mjm-12/transistor-hfe-measurement-circuit/production/bom.csv

Designator | Footprint | Quantity | Value | LCSC Part #
C1, C7 | 0805 | 2 | 1u | C28323
C10, C11, C4, C8 | 0603 | 4 | 0.1u | C14663
C12, C13 | 0603 | 2 | 10u | C96446
C14, C15 | 0805 | 2 | 2200p | C28260
C16 | 0603 | 1 | 1000p | C1588
C3 | 1206 | 1 | 22u | C12891
C5 | 0603 | 1 | 0.01u | C57112
C6 | 0603 | 1 | 100p | C14858
D1, D2 | D_SOD-123 | 2 | MMSZ5245B | C19077428
D10, D11, D6, D7, D8, D9 | D_SOD-323 | 6 | 1N4148WS | C2128
D12, D13, D14, D4, D5 | 0603 | 5 | LED(RED) | C2286
D3 | D_SOD-123 | 1 | BZT52C15 | C19077412
Q1, Q3 | SOT-23 | 2 | HL2303 | C7420345
Q2 | SOT-23 | 1 | SS8550 Y2 | C8542
Q4 | SOT-563 | 1 | SSM6L56FE | C17604697
R1, R24 | 0603 | 2 | 100k | C25803
R10, R22, R34, R35, R36, R7 | 0603 | 6 | 3k3 | C22978
R11 | 0805 | 1 | 4R7 | C17675
R12 | 0603 | 1 | 1M | C22935
R13, R17, R19 | 0603 | 3 | 1k | C21190
R14, R23 | 0603 | 2 | 10M | C7250
R15, R16, R20, R21, R26, R27, R28, R29, R3, R30, R31, R32, R33 | 0603 | 13 | 10k | C25804
R18, R25 | 0603 | 2 | 0 | C21189
R2 | 0603 | 1 | 33k | C4216
R4 | 0603 | 1 | 470k | C23178
R5 | 0603 | 1 | 47k | C25819
R6 | 0603 | 1 | 6k8 | C23212
R8 | 0603 | 1 | 22k | C31850
R9 | 0603 | 1 | 18k | C25810
U2 | SOIC-14_3.9x8.7mm_P1.27mm | 1 | 74HC14D,653 | C5605
