mjm-12/transistor-hfe-measurement-circuit/transistor-hfe-measurement-circuit.kicad_pcb

## KiCad design transistor-hfe-measurement-circuit.kicad_pcb (2026-10-15)

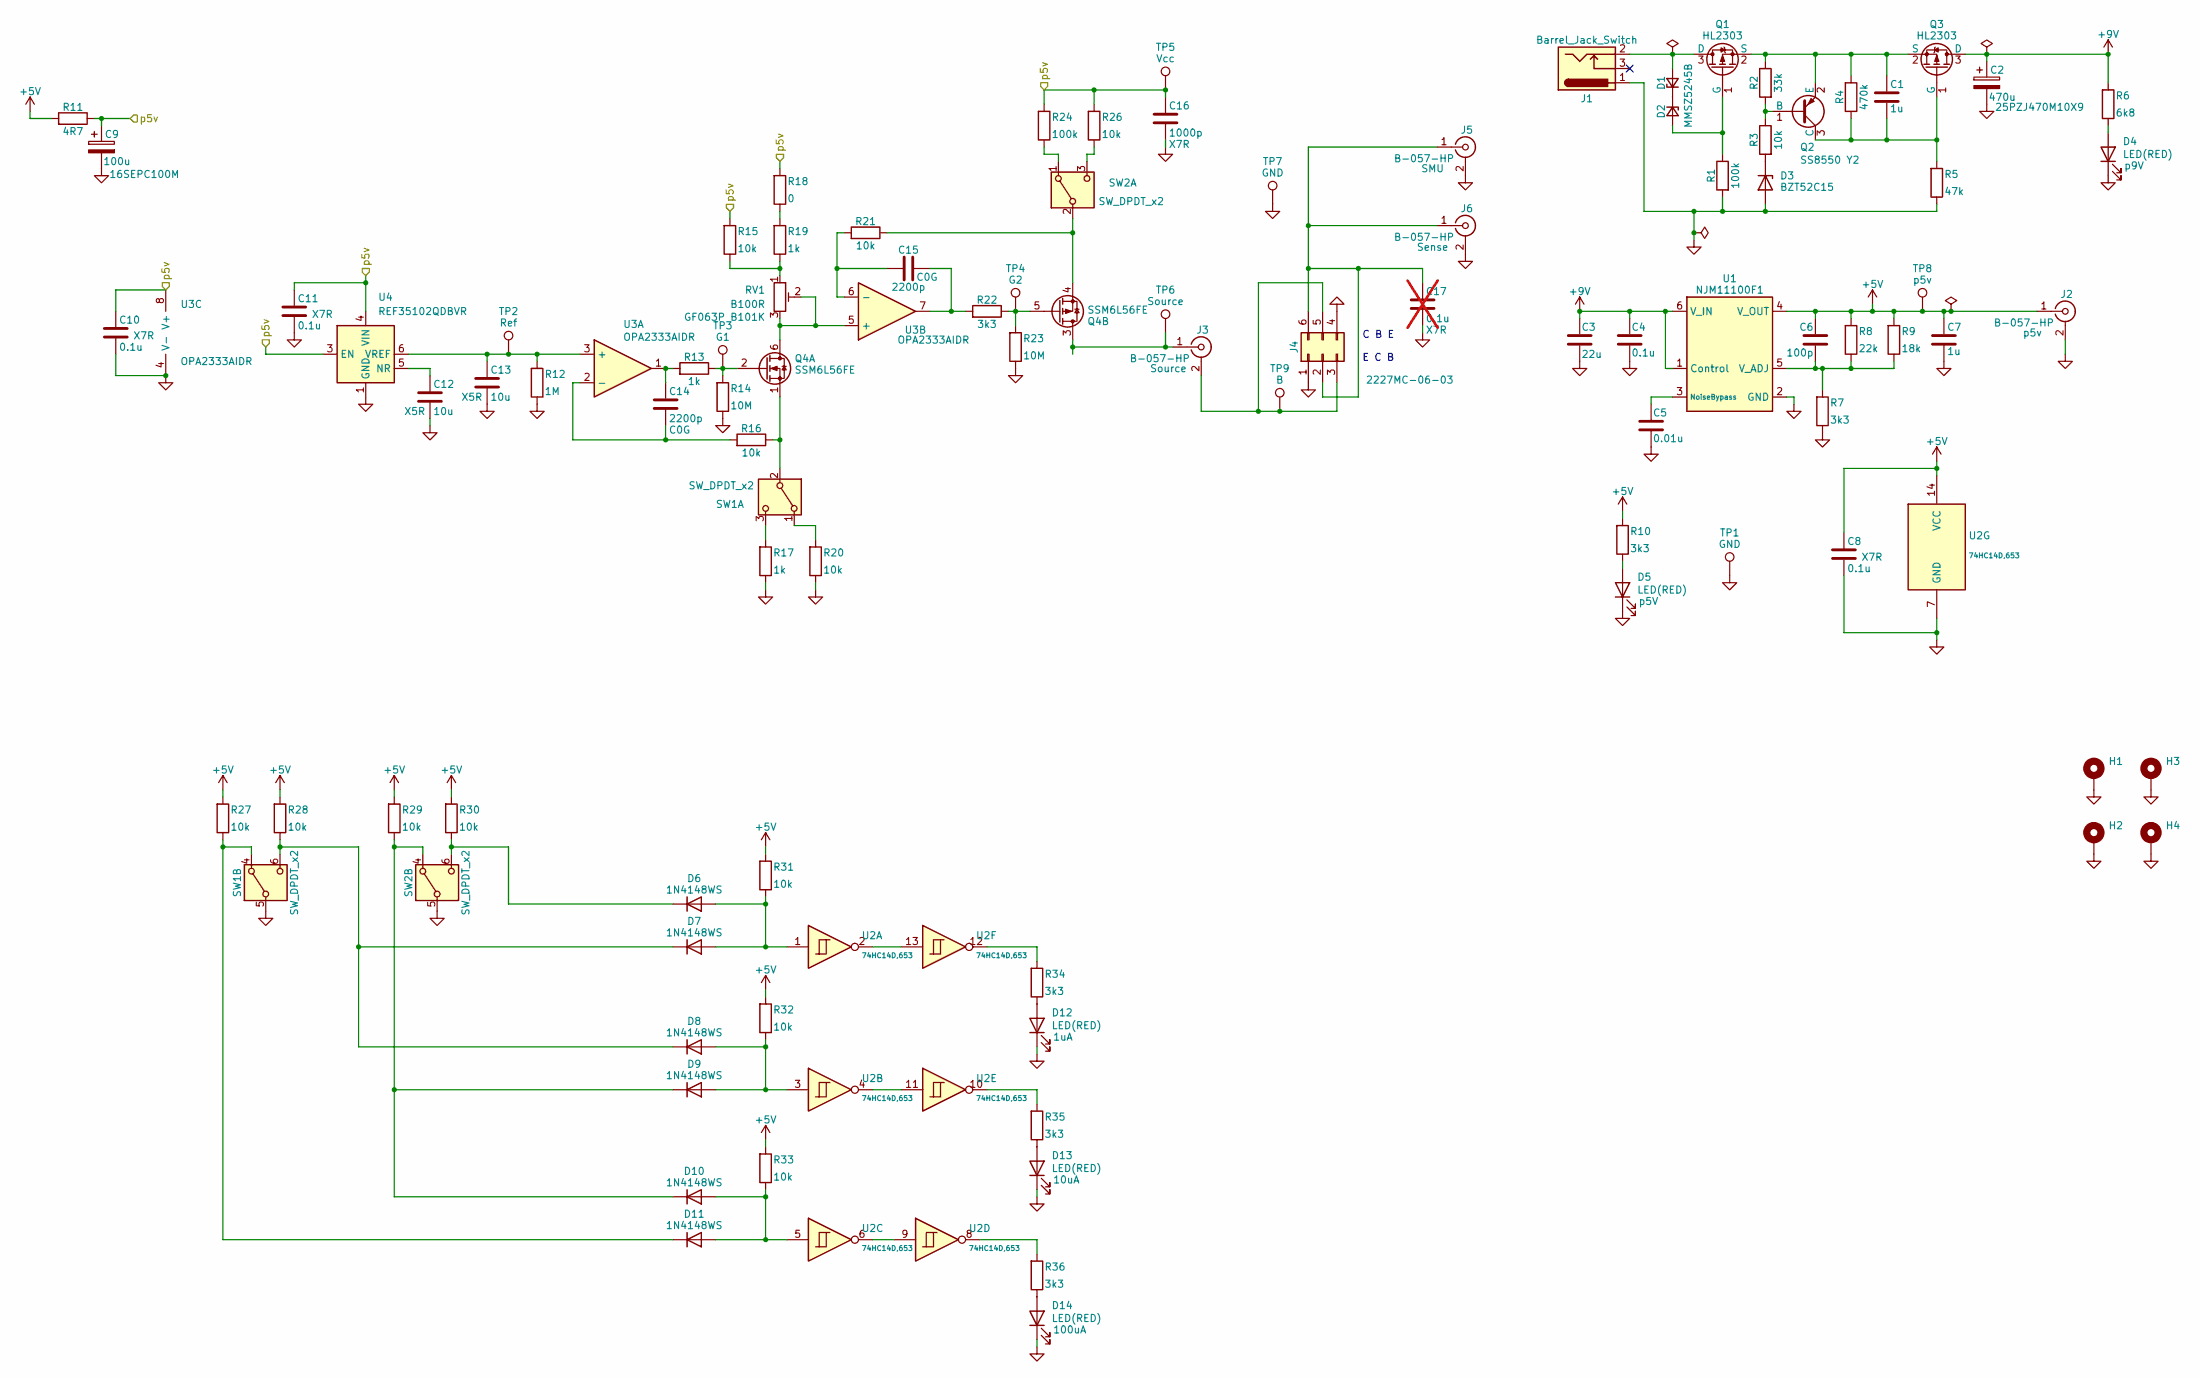
[picture p2: schematic transistor-hfe-measurement-circuit.kicad_sch, Transistor hFE Measurement Circuit Schematic]

Parts:
C1, C7: 1u; C_0805_2012Metric; LCSC C28323
C2: 470u; CP_Radial_D10.0mm_P5.00mm; MPN 25PZJ470M10X9
C3: 22u; C_1206_3216Metric; LCSC C12891
C4, C8, C10, C11: 0.1u; C_0603_1608Metric; LCSC C14663
C5: 0.01u; C_0603_1608Metric; LCSC C57112
C6: 100p; C_0603_1608Metric; LCSC C14858
C9: 100u; CP_Radial_D6.3mm_P2.50mm; MPN 16SEPC100M
C12, C13: 10u; C_0603_1608Metric; LCSC C96446
C14, C15: 2200p; C_0805_2012Metric; LCSC C28260
C16: 1000p; C_0603_1608Metric; LCSC C1588
C17: 0.1u; C_1206_3216Metric; LCSC C24497; not fitted
D1, D2: MMSZ5245B; D_SOD-123; LCSC C19077428
D3: BZT52C15; D_SOD-123; LCSC C19077412
D4, D5, D12, D13, D14: LED(RED); D_0603_1608Metric_Name; LCSC C2286
D6, D7, D8, D9, D10, D11: 1N4148WS; D_SOD-323; LCSC C2128
H1, H2, H3, H4: MountingHole_Pad; MountingHole_3.2mm_M3_DIN965_Pad
J1: Barrel_Jack_Switch; MJ-179PH_Edge
J2, J3, J5, J6: B-057-HP; COSMTEC_B-057-HP
J4: 2227MC-06-03; DIP-6_W7.62mm_Socket
Q1, Q3: HL2303; SOT-23; LCSC C7420345
Q2: SS8550 Y2; SOT-23; LCSC C8542
Q4: SSM6L56FE; SOT-563; LCSC C17604697
R1, R24: 100k; R_0603_1608Metric; LCSC C25803
R2: 33k; R_0603_1608Metric; LCSC C4216
R3, R15, R16, R20, R21, R26, R27, R28, R29, R30, R31, R32, R33: 10k; R_0603_1608Metric; LCSC C25804
R4: 470k; R_0603_1608Metric; LCSC C23178
R5: 47k; R_0603_1608Metric; LCSC C25819
R6: 6k8; R_0603_1608Metric; LCSC C23212
R7, R10, R22, R34, R35, R36: 3k3; R_0603_1608Metric; LCSC C22978
R8: 22k; R_0603_1608Metric; LCSC C31850
R9: 18k; R_0603_1608Metric; LCSC C25810
R11: 4R7; R_0805_2012Metric; LCSC C17675
R12: 1M; R_0603_1608Metric; LCSC C22935
R13, R17, R19: 1k; R_0603_1608Metric; LCSC C21190
R14, R23: 10M; R_0603_1608Metric; LCSC C7250
R18: 0; R_0603_1608Metric; LCSC C21189
RV1: B100R; TCOS_GF063P; MPN GF063P B101K
SW1, SW2: SW_DPDT_x2; SW_NKK_SS22SDP2
TP1, TP2, TP3, TP4, TP5, TP6, TP7, TP8, TP9: TestPoint; TestPoint_THTPad_D2.0mm_Drill1.0mm_ValueSilk-name
U1: NJM11100F1; SOT-23-6_Handsoldering
U2: 74HC14D,653; SOIC-14_3.9x8.7mm_P1.27mm; LCSC C5605
U3: OPA2333AIDR; SOIC-8_3.9x4.9mm_P1.27mm
U4: REF35102QDBVR; SOT-23-6

Connections:
+5V: C6.1, C7.1, C8.1, J2.1 (In), R8.1, R9.1, R10.1, R11.1, R27.1, R28.1, R29.1, R30.1, R31.1, R32.1, R33.1, TP8.1 (1_1), U1.4 (V_OUT), U2.14 (VCC)
+9V: C2.1, C3.1, C4.1, Q3.3 (D), R6.1, U1.1 (Control), U1.6 (V_IN)
/p5v: C9.1, C10.1, C11.1, C16.1, R11.2, R15.1, R18.1, R24.1, R26.1, TP5.1 (1_1), U3.8 (V+), U4.3 (EN), U4.4 (VIN)
GNDPWR: C2.2, C3.2, C4.2, C5.2, C7.2, C8.2, C9.2, C10.2, C11.2, C12.2, C13.2, C16.2, C17.2, D3.2 (A), D4.1 (K), D5.1 (K), D12.1 (K), D13.1 (K), D14.1 (K), H1.1 (1_1), H2.1 (1_1), H3.1 (1_1), H4.1 (1_1), J1.1, J2.2 (Ext), J4.1, J4.4, J5.2 (Ext), J6.2 (Ext), R1.1, R5.2, R7.2, R12.2, R14.2, R17.2, R20.2, R23.2, SW1.5 (B), SW2.5 (B), TP1.1 (1_1), TP7.1 (1_1), U1.2 (GND), U2.7 (GND), U3.4 (V-), U4.1 (GND), U4.2 (GND)
unnamed: C14.1, R13.1, U3.1
unnamed: C15.2, R22.1, U3.7
unnamed: D1.2 (A), J1.2, Q1.3 (D)
unnamed: D1.1 (K), D2.1 (K)
unnamed: D2.2 (A), Q1.1 (G), R1.2
unnamed: D3.1 (K), R3.1
unnamed: D4.2 (A), R6.2
unnamed: D5.2 (A), R10.2
unnamed: D6.2 (A), D7.2 (A), R31.2, U2.1
unnamed: D6.1 (K), R30.2, SW2.6 (C)
unnamed: D7.1 (K), D8.1 (K), R28.2, SW1.6 (C)
unnamed: D8.2 (A), D9.2 (A), R32.2, U2.3
unnamed: D10.2 (A), D11.2 (A), R33.2, U2.5
unnamed: D9.1 (K), D10.1 (K), R29.2, SW2.4 (A)
unnamed: D11.1 (K), R27.2, SW1.4 (A)
unnamed: D12.2 (A), R34.2
unnamed: D13.2 (A), R35.2
unnamed: D14.2 (A), R36.2
unnamed: J3.2 (Ext), J4.3, J4.5, TP9.1 (1_1)
unnamed: J3.1 (In), Q4.3 (D), TP6.1 (1_1)
unnamed: C17.1, J4.2, J4.6, J5.1 (In), J6.1 (In)
unnamed: C1.1, Q1.2 (S), Q2.2 (E), Q3.2 (S), R2.2, R4.1
unnamed: Q2.1 (B), R2.1, R3.2
unnamed: C1.2, Q2.3 (C), Q3.1 (G), R4.2, R5.1
unnamed: Q4.6 (D), RV1.2, RV1.3, U3.5 (+)
unnamed: Q4.2 (G), R13.2, R14.1, TP3.1 (1_1)
unnamed: Q4.1 (S), R16.2, SW1.2 (B)
unnamed: Q4.5 (G), R22.2, R23.1, TP4.1 (1_1)
unnamed: Q4.4 (S), R21.2, SW2.2 (B)
unnamed: R15.2, R19.2, RV1.1
unnamed: R18.2, R19.1
unnamed: R34.1, U2.12
unnamed: R35.1, U2.10
unnamed: R36.1, U2.8
unnamed: R20.1, SW1.1 (A)
unnamed: R17.1, SW1.3 (C)
unnamed: R24.2, SW2.1 (A)
unnamed: R26.2, SW2.3 (C)
unnamed: C5.1, U1.3 (NoiseBypass)
unnamed: C6.2, R7.1, R8.2, R9.2, U1.5 (V_ADJ)
unnamed: U2.6, U2.9
unnamed: U2.4, U2.11
unnamed: U2.2, U2.13
unnamed: C13.1, R12.1, TP2.1 (1_1), U3.3 (+), U4.6 (VREF)
unnamed: C14.2, R16.1, U3.2 (-)
unnamed: C15.1, R21.1, U3.6 (-)
unnamed: C12.1, U4.5 (NR)

Notes on the sheet:
C B E E C B

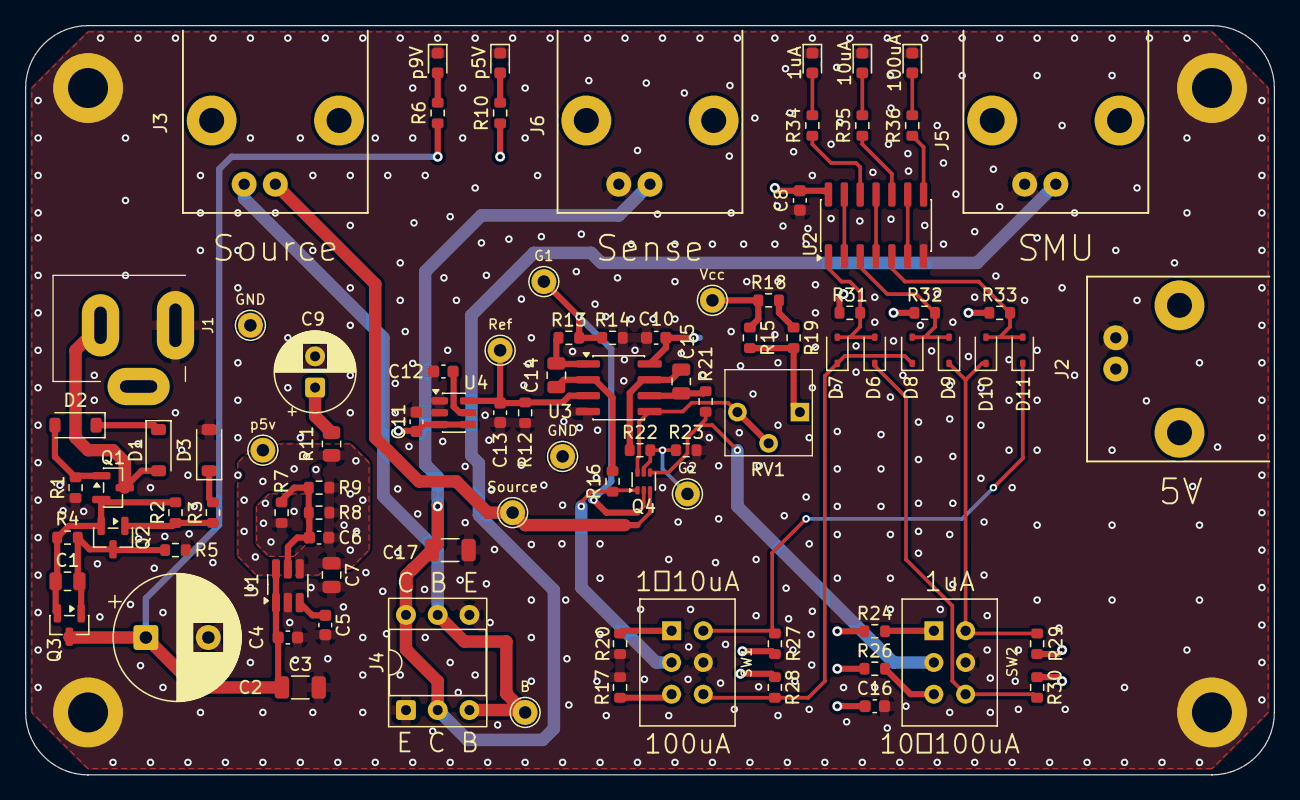
[picture p3: board transistor-hfe-measurement-circuit.kicad_pcb from above]

Board: 4 copper layers, 100.0 x 60.0 mm, 96 parts (0 on the bottom side), 51 nets.
