mjm-12/transistor-hfe-measurement-circuit/(commit log)

2026-10-15 feat: v1.1 として現行版の定電流回路を取り込む
    HVRF リポジトリの作業ツリー（2026-10-15 時点）を v1.1 として取り込む。
    - プロジェクトを transistor-hfe-measurement-circuit に改名
    （サブシートは cc-component.kicad_sch）
    - 回路図・PCB のタイトルブロックに版数・著作権・ライセンス
    （CERN-OHL-P v2）・リポジトリ URL を入れる
    - 基板シルクの版数を V1.0 から V1.1 にする
    - PCB にはメーカー製 3D モデルを埋め込まず、DC ジャックは自作の
    簡易モデルを参照する
    [cc-component.kicad_sch, transistor-hfe-measurement-circuit.kicad_pcb, transistor-hfe-measurement-circuit.kicad_sch]
2026-10-15 feat: Transistor hFE measurement circuit v1.0 を取り込む
    HVRF リポジトリの 03b65b5（order submitted, 2026-07-02）時点の
    constant-current-kairo を初版として取り込む。
    - PCB に埋め込まれていたメーカー製 3D モデル（embedded_files）を除き、
    DC ジャックは自作の簡易モデル libs/3dmodels/DCJack_Marushin_MJ-179PH_Edge.step
    を参照する
    - 存在しない ${KIPRJMOD}/enclosure/B-057-HP.stp への 3D モデル参照を外す
    - 未使用の Library/ は含めない
    [2026-05-23__constant-current-kairo.kicad_pcb, 2026-05-23__constant-current-kairo.kicad_sch, 2026-06-25__cc-component.kicad_sch, bom.csv, designators.csv, positions.csv]
2026-10-15 docs: 回路図の PNG を README に載せ、はみ出たワイヤを消す
    - 回路図 PDF を 200 dpi の PNG に変換して docs/schematic.png に置き、
    README から表示する
    - 回路図ではみ出ていたワイヤとジャンクションを削除する
    [transistor-hfe-measurement-circuit.kicad_sch]
