mjm-12/transistor-hfe-measurement-circuit/(notices)

Notices in the files:
transistor-hfe-measurement-circuit.kicad_sch:
Licensed under CERN-OHL-P v2
